bartekM-pl/epdiy-hardware/epdiy-v7/plots/epdiy-v7.pdf

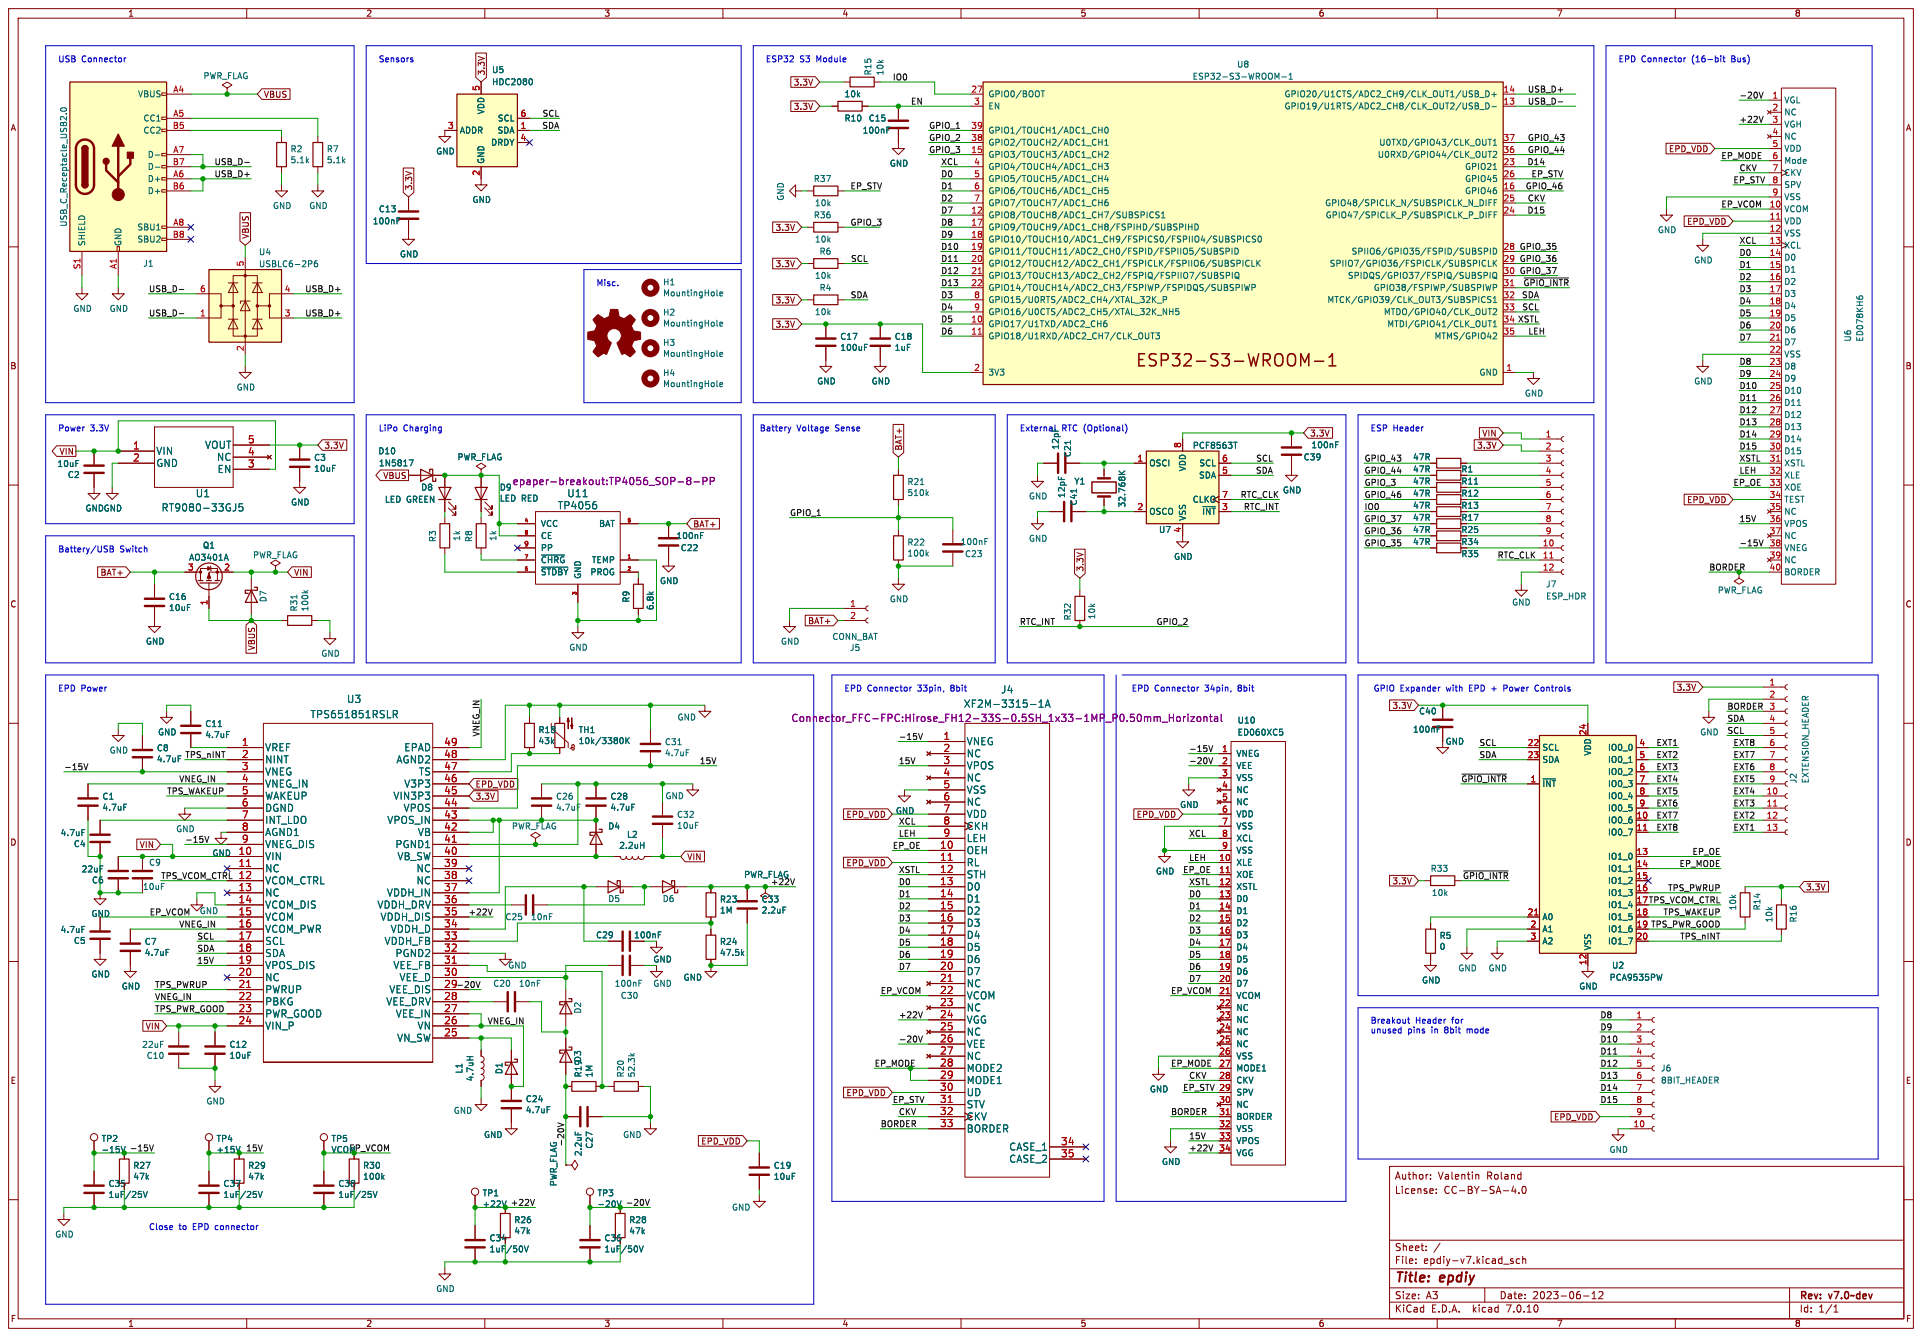
[picture p1: page 1]

5 SCL 6 U5 HDC2080 GND VREF 1 VIN 10 NC 11 VCOM_CTRL 12 NC 13 VCOM_DIS 14 VCOM 15 VCOM_PWR 16 SCL 17 SDA 18 VPOS_DIS 19 NINT 2 NC 20 PWRUP 21 PBKG 22 PWR_GOOD 23 VIN_P 24 VN_SW 25 VN 26 VEE_IN 27 VEE_DRV 28 VEE_DIS 29 VNEG 3 VEE_D 30 VEE_FB 31 PGND2 32 VDDH_FB 33 VDDH_D 34 VDDH_DIS 35 VDDH_DRV 36 VDDH_IN 37 NC 38 NC 39 VNEG_IN 4 VB_SW 40 PGND1 41 VB 42 VPOS_IN 43 VPOS 44 VIN3P3 45 V3P3 46 TS 47 AGND2 48 EPAD 49 WAKEUP 5 DGND 6

5 SCL 6 GND GND GND

3 VCC 4 BAT 5 ~{STDBY} 6 ~{CHRG} 7 CE 8 PP 9 PWR_FLAG

4 SDA 5 SCL 6 CLKO 7 VDD

3 VCC 4 BAT 5 ~{STDBY} 6 ~{CHRG} 7 CE 8 PP 9 U11 TP4056

U10 ED060XC5 VNEG 1 XLE 10 XOE 11 XSTL 12 D0 13 D1 14 D2 15 D3 16 D4 17 D5 18 D6 19 VEE 2 D7 20 VCOM 21 NC 22 NC 23 NC 24 NC 25 VSS 26 MODE1 27 CKV 28 SPV 29 VSS 3 NC 30 BORDER 31 VSS 32 VPOS 33 VGG 34 NC 4 NC 5 VDD 6 VSS 7 XCL 8 VSS 9 GND

VNEG 1 XLE 10 XOE 11 XSTL 12 D0 13 D1 14 D2 15 D3 16 D4 17 D5 18 D6 19 VEE 2 D7 20 VCOM 21 NC 22 NC 23 NC 24 NC 25 VSS 26 MODE1 27 CKV 28 SPV 29 VSS 3 NC 30 BORDER 31 VSS 32 VPOS 33 VGG 34 NC 4 NC 5 VDD 6 VSS 7 XCL 8 VSS 9 U10 ED060XC5 GND

Close to EPD connector
