bartekM-pl/epdiy-hardware/epdiy-v7/epdiy-v7.kicad_pcb

## KiCad design epdiy-v7/epdiy-v7.kicad_pcb (2024-01-09)

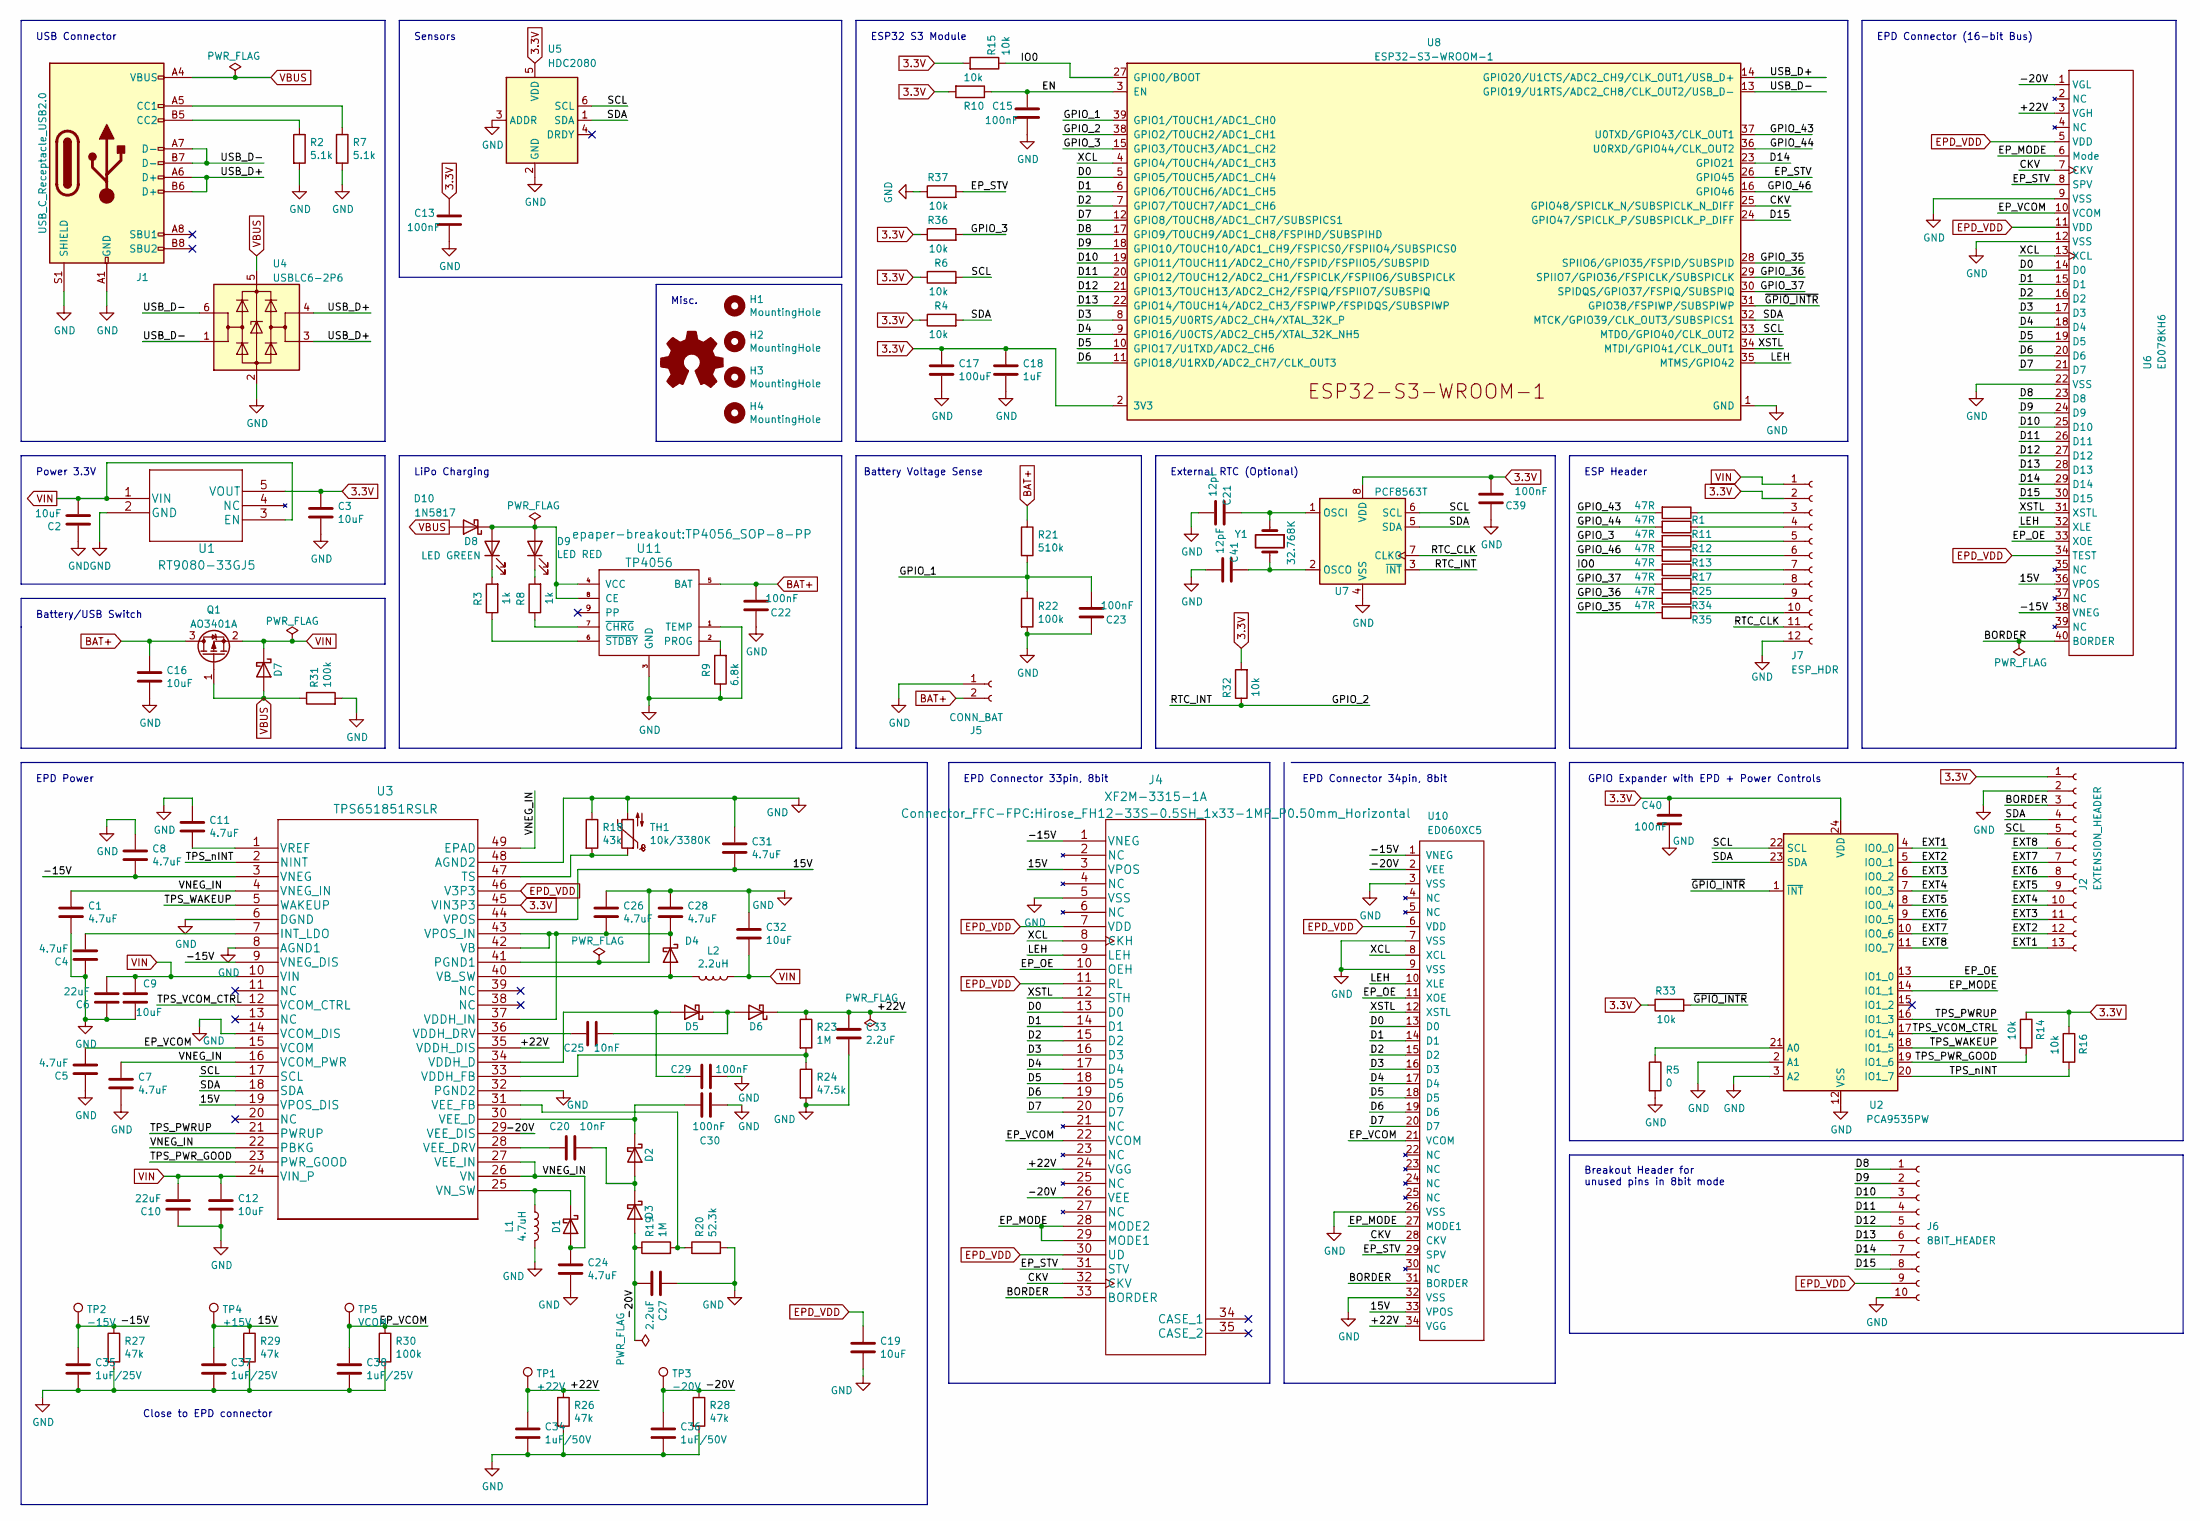
[picture p2: schematic epdiy-v7.kicad_sch, epdiy]

Parts:
C1, C4, C5, C7, C8, C11, C24, C26, C28, C31: 4.7uF; C_0805_2012Metric; LCSC C1779
C2, C3, C9, C12, C16, C19, C32: 10uF; C_0805_2012Metric; LCSC C15850
C6, C10: 22uF; C_0805_2012Metric; LCSC C45783
C13: 100nF; C_0603_1608Metric; LCSC C49678
C15, C22, C23, C29, C30, C39, C40: 100nF; C_0805_2012Metric; LCSC C49678
C17: 100uF; CP_EIA-3528-15_AVX-H; LCSC C16133
C18: 1uF; C_0805_2012Metric; LCSC C28323
C20, C25: 10nF; C_0805_2012Metric; LCSC C1710
C21, C41: 12pF; C_0603_1608Metric; LCSC C38523
C27, C33: 2.2uF; C_0805_2012Metric; LCSC C377773
C34, C36: 1uF/50V; C_1206_3216Metric; LCSC C1848
C35, C37, C38: 1uF/25V; C_0805_2012Metric; LCSC C28323
D1, D2, D3, D4, D5, D6, D7: MBR0540; D_SOD-123; LCSC C8598
D8: LED GREEN; LED_0603_1608Metric; LCSC C72043
D9: LED RED; LED_0603_1608Metric; LCSC C72038
D10: 1N5817; D_SOD-123; LCSC C8598
H1, H2, H3, H4: MountingHole; MountingHole_2.2mm_M2
J1: USB_C_Receptacle_USB2.0; USB_C_Receptacle_HRO_TYPE-C-31-M-12; LCSC C165948
J2: EXTENSION_HEADER; PinHeader_1x13_P2.54mm_Vertical
J4: XF2M-3315-1A; Hirose_FH12-33S-0.5SH_1x33-1MP_P0.50mm_Horizontal; LCSC C597986
J5: CONN_BAT; PinHeader_1x02_P2.54mm_Vertical
J6: 8BIT_HEADER; PinHeader_1x10_P2.54mm_Vertical
J7: ESP_HDR; PinHeader_1x12_P2.54mm_Vertical
L1: 4.7uH; L_Taiyo-Yuden_NR-50xx_HandSoldering; LCSC C222947
L2: 2.2uH; L_Taiyo-Yuden_NR-40xx_HandSoldering; LCSC C92959
Q1: AO3401A; SOT-23; LCSC C15127
R1, R11, R12, R13, R17, R25, R34, R35: 47R; R_0603_1608Metric; LCSC C25804
R2, R7: 5.1k; R_0603_1608Metric; LCSC C23186
R3, R8: 1k; R_0603_1608Metric; LCSC C21190
R4, R6, R10, R14, R15, R16, R32, R33, R36, R37: 10k; R_0603_1608Metric; LCSC C25804
R5: 0; R_0603_1608Metric; LCSC C21189
R9: 6.8k; R_0603_1608Metric; LCSC C23212
R18: 43k; R_0603_1608Metric; LCSC C23172
R19, R23: 1M; R_0603_1608Metric; LCSC C22935
R20: 52.3k; R_0603_1608Metric; LCSC C23196
R21: 510k; R_0603_1608Metric; LCSC C23192
R22: 100k; R_0603_1608Metric; LCSC C22807
R24: 47.5k; R_0603_1608Metric; LCSC C25819
R26, R27, R28, R29: 47k; R_0603_1608Metric; LCSC C25819
R30, R31: 100k; R_0603_1608Metric; LCSC C25803
TH1: 10k/3380K; R_0603_1608Metric; LCSC C76589
TP1: +22V; TestPoint_Pad_D2.5mm
TP2: -15V; TestPoint_Pad_D2.5mm
TP3: -20V; TestPoint_Pad_D2.5mm
TP4: +15V; TestPoint_Pad_D2.5mm
TP5: VCOM; TestPoint_Pad_D2.5mm
U1: RT9080-33GJ5; TSOT-23-5; LCSC C841192
U2: PCA9535PW; TSSOP-24_4.4x7.8mm_P0.65mm; LCSC C2652292
U3: TPS651851RSLR; LCSC C139292
U4: USBLC6-2P6; SOT-666; LCSC C2827693
U5: HDC2080; Texas_PWSON-N6; LCSC C918141
U6: ED078KH6; Hirose_FH12-40S-0.5SH_1x40-1MP_P0.50mm_Horizontal; LCSC C202114
U7: PCF8563T; SOIC-8_3.9x4.9mm_P1.27mm; LCSC C7440
U8: ESP32-S3-WROOM-1; LCSC C2913202
U10: ED060XC5; X05A20H34G; LCSC C528053
U11: TP4056; TP4056_SOP-8-PP; LCSC C16581
Y1: 32.768K; Crystal_SMD_3215-2Pin_3.2x1.5mm; LCSC C32346

Connections:
3.3V: C3.2, C13.1, C17.1, C18.2, C39.2, C40.1, J2.1, J7.2, R4.1, R6.1, R10.2, R14.1, R15.2, R16.1, R32.2, R33.1, R36.1, U1.5 (VOUT), U2.24 (VDD), U3.45 (VIN3P3), U5.5 (VDD), U7.8 (VDD), U8.2 (3V3)
/15V: C31.2, C37.1, J4.3 (VPOS), R29.1, TP4.1, U3.19 (VPOS_DIS), U3.44 (VPOS), U6.36 (VPOS), U10.33 (VPOS)
/+22V: C33.1, C34.1, D6.1 (K), J4.24 (VGG), R23.1, R26.1, TP1.1, U3.35 (VDDH_DIS), U6.3 (VGH), U10.34 (VGG)
/-15V: C8.2, C35.1, J4.1 (VNEG), R27.1, TP2.1, U3.3 (VNEG), U3.9 (VNEG_DIS), U6.38 (VNEG), U10.1 (VNEG)
/-20V: C27.2, C36.1, D3.2 (A), J4.26 (VEE), R19.1, R28.1, TP3.1, U3.29 (VEE_DIS), U6.1 (VGL), U10.2 (VEE)
/CKV: J4.32 (CKV), U6.7 (CKV), U8.25 (GPIO48/SPICLK_N/SUBSPICLK_N_DIFF), U10.28 (CKV)
/D0: J4.13 (D0), U6.14 (D0), U8.5 (GPIO5/TOUCH5/ADC1_CH4), U10.13 (D0)
/D1: J4.14 (D1), U6.15 (D1), U8.6 (GPIO6/TOUCH6/ADC1_CH5), U10.14 (D1)
/D2: J4.15 (D2), U6.16 (D2), U8.7 (GPIO7/TOUCH7/ADC1_CH6), U10.15 (D2)
/D3: J4.16 (D3), U6.17 (D3), U8.8 (GPIO15/U0RTS/ADC2_CH4/XTAL_32K_P), U10.16 (D3)
/D4: J4.17 (D4), U6.18 (D4), U8.9 (GPIO16/U0CTS/ADC2_CH5/XTAL_32K_NH5), U10.17 (D4)
/D5: J4.18 (D5), U6.19 (D5), U8.10 (GPIO17/U1TXD/ADC2_CH6), U10.18 (D5)
/D6: J4.19 (D6), U6.20 (D6), U8.11 (GPIO18/U1RXD/ADC2_CH7/CLK_OUT3), U10.19 (D6)
/D7: J4.20 (D7), U6.21 (D7), U8.12 (GPIO8/TOUCH8/ADC1_CH7/SUBSPICS1), U10.20 (D7)
/D8: J6.1, U6.23 (D8), U8.17 (GPIO9/TOUCH9/ADC1_CH8/FSPIHD/SUBSPIHD)
/D9: J6.2, U6.24 (D9), U8.18 (GPIO10/TOUCH10/ADC1_CH9/FSPICS0/FSPIIO4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)
/D10: J6.3, U6.25 (D10), U8.19 (GPIO11/TOUCH11/ADC2_CH0/FSPID/FSPIIO5/S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)
/D11: J6.4, U6.26 (D11), U8.20 (GPIO12/TOUCH12/ADC2_CH1/FSPICLK/FSPIIO6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)
/D12: J6.5, U6.27 (D12), U8.21 (GPIO13/TOUCH13/ADC2_CH2/FSPIQ/FSPIIO7/S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)
/D13: J6.6, U6.28 (D13), U8.22 (GPIO14/TOUCH14/ADC2_CH3/FSPIWP/FSPIDQS/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)
/D14: J6.7, U6.29 (D14), U8.23 (GPIO21)
/D15: J6.8, U6.30 (D15), U8.24 (GPIO47/SPICLK_P/SUBSPICLK_P_DIFF)
/EN: C15.1, R10.1, U8.3 (EN)
/EP_MODE: J4.28 (MODE2), J4.29 (MODE1), U2.14 (IO1_1), U6.6 (Mode), U10.27 (MODE1)
/EP_OE: J4.10 (OEH), U2.13 (IO1_0), U6.33 (XOE), U10.11 (XOE)
/EP_STV: J4.31 (STV), R37.2, U6.8 (SPV), U8.26 (GPIO45), U10.29 (SPV)
/EP_VCOM: C5.2, C38.1, J4.22 (VCOM), R30.1, TP5.1, U3.15 (VCOM), U6.10 (VCOM), U10.21 (VCOM)
/EXT1: J2.13, U2.4 (IO0_0)
/EXT2: J2.12, U2.5 (IO0_1)
/EXT3: J2.11, U2.6 (IO0_2)
/EXT4: J2.10, U2.7 (IO0_3)
/EXT5: J2.9, U2.8 (IO0_4)
/EXT6: J2.8, U2.9 (IO0_5)
/EXT7: J2.7, U2.10 (IO0_6)
/EXT8: J2.6, U2.11 (IO0_7)
/GPIO_1: C23.2, R21.2, R22.1, U8.39 (GPIO1/TOUCH1/ADC1_CH0)
/GPIO_2: R32.1, U7.3 (~INT), U8.38 (GPIO2/TOUCH2/ADC1_CH1)
/GPIO_3: R12.2, R36.2, U8.15 (GPIO3/TOUCH3/ADC1_CH2)
/GPIO_35: R35.2, U8.28 (SPIIO6/GPIO35/FSPID/SUBSPID)
/GPIO_36: R34.2, U8.29 (SPIIO7/GPIO36/FSPICLK/SUBSPICLK)
/GPIO_37: R25.2, U8.30 (SPIDQS/GPIO37/FSPIQ/SUBSPIQ)
/GPIO_43: R1.2, U8.37 (U0TXD/GPIO43/CLK_OUT1)
/GPIO_44: R11.2, U8.36 (U0RXD/GPIO44/CLK_OUT2)
/GPIO_46: R13.2, U8.16 (GPIO46)
/IO0: R15.1, R17.2, U8.27 (GPIO0/BOOT)
/LEH: J4.9 (LEH), U6.32 (XLE), U8.35 (MTMS/GPIO42), U10.10 (XLE)
/RTC_CLK: J7.11, U7.7 (CLKO)
/SCL: J2.5, R6.2, U2.22 (SCL), U3.17 (SCL), U5.6 (SCL), U7.6 (SCL), U8.33 (MTDO/GPIO40/CLK_OUT2)
/SDA: J2.4, R4.2, U2.23 (SDA), U3.18 (SDA), U5.1 (SDA), U7.5 (SDA), U8.32 (MTCK/GPIO39/CLK_OUT3/SUBSPICS1)
/TPS_PWRUP: U2.16 (IO1_3), U3.21 (PWRUP)
/TPS_PWR_GOOD: R14.2, U2.19 (IO1_6), U3.23 (PWR_GOOD)
/TPS_VCOM_CTRL: U2.17 (IO1_4), U3.12 (VCOM_CTRL)
/TPS_WAKEUP: U2.18 (IO1_5), U3.5 (WAKEUP)
/TPS_nINT: R16.2, U2.20 (IO1_7), U3.2 (NINT)
/USB_D+: J1.A6 (D+), J1.B6 (D+), U4.3 (I/O2), U4.4 (I/O2), U8.14 (GPIO20/U1CTS/ADC2_CH9/CLK_OUT1/USB_D+)
/USB_D-: J1.A7 (D-), J1.B7 (D-), U4.1 (I/O1), U4.6 (I/O1), U8.13 (GPIO19/U1RTS/ADC2_CH8/CLK_OUT2/USB_D-)
/VNEG_IN: C1.1, C7.1, C24.1, D1.2 (A), U3.4 (VNEG_IN), U3.16 (VCOM_PWR), U3.22 (PBKG), U3.26 (VN), U3.27 (VEE_IN), U3.49 (EPAD)
/XCL: J4.8 (CKH), U6.13 (XCL), U8.4 (GPIO4/TOUCH4/ADC1_CH3), U10.8 (XCL)
/XSTL: J4.12 (STH), U6.31 (XSTL), U8.34 (MTDI/GPIO41/CLK_OUT1), U10.12 (XSTL)
/~GPIO_INTR: R33.2, U2.1 (~INT), U8.31 (GPIO38/FSPIWP/SUBSPIWP)
BAT+: C16.2, C22.2, J5.2, Q1.3 (D), R21.1, U11.5 (BAT)
EPD_VDD: C19.1, J4.7 (VDD), J4.11 (RL), J4.30 (UD), J6.9, U3.46 (V3P3), U6.5 (VDD), U6.11 (VDD), U6.34 (TEST), U10.6 (VDD)
unnamed: D1.1 (K), L1.1, U3.25 (VN_SW)
unnamed: C20.1, D2.2 (A), D3.1 (K)
unnamed: C30.1, D2.1 (K), U3.30 (VEE_D)
unnamed: D4.2 (A), L2.2, U3.40 (VB_SW)
unnamed: C26.2, C28.2, D4.1 (K), U3.37 (VDDH_IN), U3.42 (VB), U3.43 (VPOS_IN)
unnamed: C29.2, D5.2 (A), U3.34 (VDDH_D)
unnamed: C25.1, D5.1 (K), D6.2 (A)
unnamed: D8.1 (K), R3.2
unnamed: D9.1 (K), R8.2
unnamed: D8.2 (A), D9.2 (A), D10.1 (K), U11.4 (VCC), U11.8 (CE)
unnamed: J1.A5 (CC1), R7.1
unnamed: J1.B5 (CC2), R2.1
unnamed: J7.3, R1.1
unnamed: J7.4, R11.1
unnamed: J7.5, R12.1
unnamed: J7.6, R13.1
unnamed: J7.7, R17.1
unnamed: J7.8, R25.1
unnamed: J7.9, R34.1
unnamed: J7.10, R35.1
unnamed: R5.1, U2.21 (A0)
unnamed: C4.2, U3.7 (INT_LDO)
unnamed: R18.2, TH1.1, U3.47 (TS)
unnamed: C25.2, U3.36 (VDDH_DRV)
unnamed: R23.2, R24.1, U3.33 (VDDH_FB)
unnamed: C20.2, U3.28 (VEE_DRV)
unnamed: R19.2, R20.1, U3.31 (VEE_FB)
unnamed: C11.2, U3.1 (VREF)
unnamed: C21.2, U7.1 (OSCI), Y1.1
unnamed: C41.2, U7.2 (OSCO), Y1.2
unnamed: R9.2, U11.2 (PROG)
unnamed: R8.1, U11.7 (~CHRG)
unnamed: R3.1, U11.6 (~STDBY)
VIN: C2.1, C6.2, C9.1, C10.2, C12.1, C32.2, D7.1 (K), J7.1, L2.1, Q1.2 (S), U1.1 (VIN), U1.3 (EN), U3.10 (VIN), U3.24 (VIN_P)

Notes on the sheet:
Battery Voltage Sense
Misc.
EPD Power
ESP Header
GPIO Expander with EPD + Power Controls
USB Connector
EPD Connector (16-bit Bus)
ESP32 S3 Module
Power 3.3V
EPD Connector 33pin, 8bit
Battery/USB Switch
External RTC (Optional)
EPD Connector 34pin, 8bit
Sensors
Breakout Header for unused pins in 8bit mode
LiPo Charging
Close to EPD connector

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
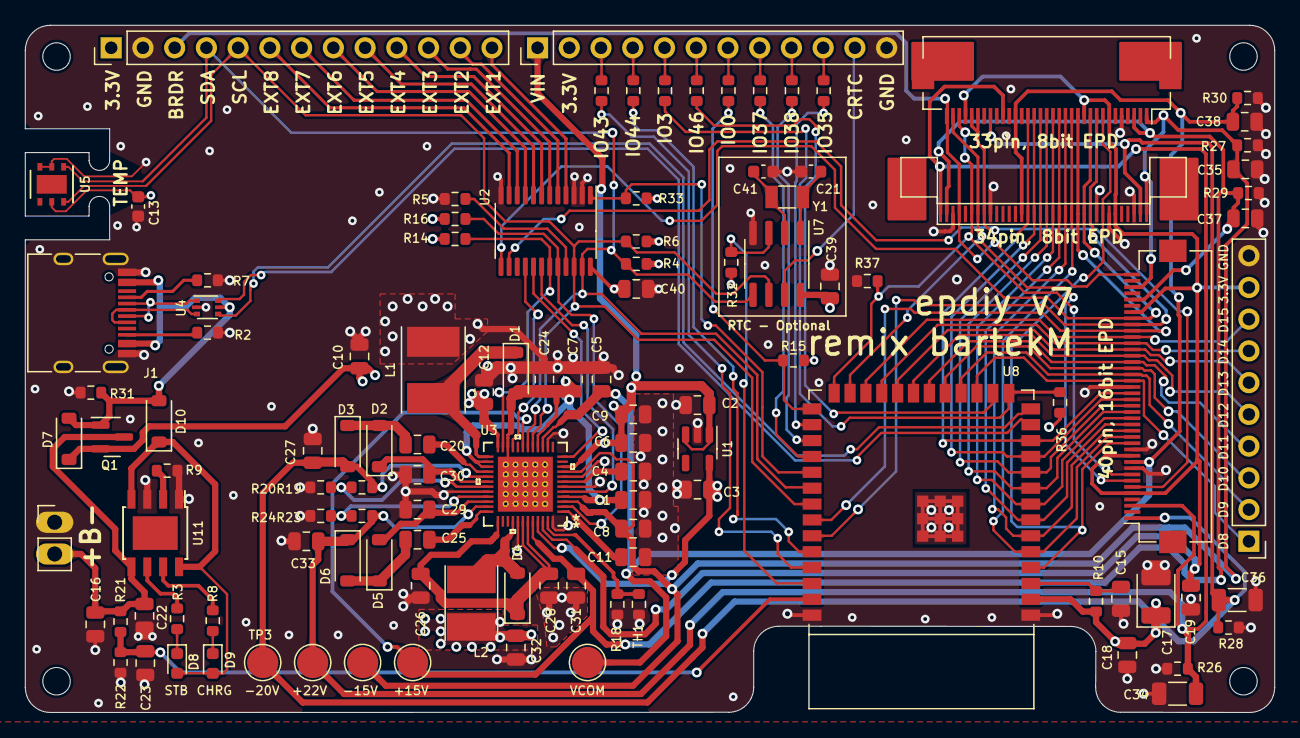
[picture p3: board epdiy-v7.kicad_pcb from above]

Board: 4 copper layers, 100.0 x 55.0 mm, 117 parts (0 on the bottom side), 99 nets.
