bartekM-pl/epdiy-hardware/(notices)

Notices in the files:
epdiy-v7/epdiy-v7.kicad_sch:
License: CC-BY-SA-4.0
parts and their libraries:
Copyright 2016 Accelerated Designs. All rights reserved.
